74ls00/ComponentTester/FW_Git/ReadMe.md

[WinAVR 20100110](https://sourceforge.net/projects/winavr/files/WinAVR/20100110/)
