74ls00/ComponentTester/HW_EAGLE/ReadMe.txt

Дроссель стабитронов.
Гантелька обмотана 1-2 слоями скотча.
Намотано 49 витков проводом 0.32мм до 100мкгн.
Покрыто густым цапонлаком, насквозь. Не сушил, не было времени.
Обмотано 1-2 слоями скотча.
От конца первичной намотано 400 витков проводом 0.15мм секциями по 100, полученная индуктивность 6.8мгн.
Покрыто цапонлаком в несколько слоёв.
Конец в термоусадке 1мм, связан нитками чтоб не разматывалось.
После сушки. Изолировано 1 слоем скотча.
1 перекрывающий незамкнутый виток медной фольги.
Провод припян с краю и уложен в канавку пайкой внутрь. Край фольги с пайкой оклеен скотчем, фольга намотана на клей "Момент классик".
Обтянуто термоучадкой размер 8 (10мм) растянутой узкогубцами до 12мм, чтоб тоньше было.
