74ls00/ComponentTester/Links/ReadMe.txt

forum.html - список ссылок форума проекта. 

Список содержит ссылки и некоторую группировку, но посколько в теме уже были сотни ст раниц и писался он с большими перерывами в течении нескольких лет, указатели могут быть не полными или изменёнными.

Файл  должен быть открыт в браузере.
Файл не содержит скриптов, но из за большого количества ссылок, хостинги его определяют как мошеннический.
