74ls00/ComponentTester/HW_EAGLE/TODO.txt

2018

резистор 10к со входа транзистора кнопки

***************************************

включение измерителя стабилитронов
pc3 pin26 zener v meter 10:1
config_328.h line:439
config.h line:115

делитель
tools.c line:1670
Value /= 10;                 /* scale to 0.1V */ 
для деления на 20 (вх5в=инд100в) установить 5

конденсатор включения кнопки при проверке стабилитронов чтоб не держать
http://vrtp.ru/index.php?showtopic=16451&view=findpost&p=744082

***************************************

pc4 pin27 relay (line 102) and 2v5 (line 82)

изменить панель гнёзд для всех комбинаций.
gm328
1232123
надо
1232132

old
328p pd4 pin2 измерение частоты.
хейцметр. в хейцгаях

высота платы с чипами 10,5мм
высота реле 9,5мм
	от экрана до платы 20мм
