74ls00/ComponentTester/HW_EAGLE/b333.brd

## EAGLE design HW_EAGLE/b333.brd (2021-04-29)

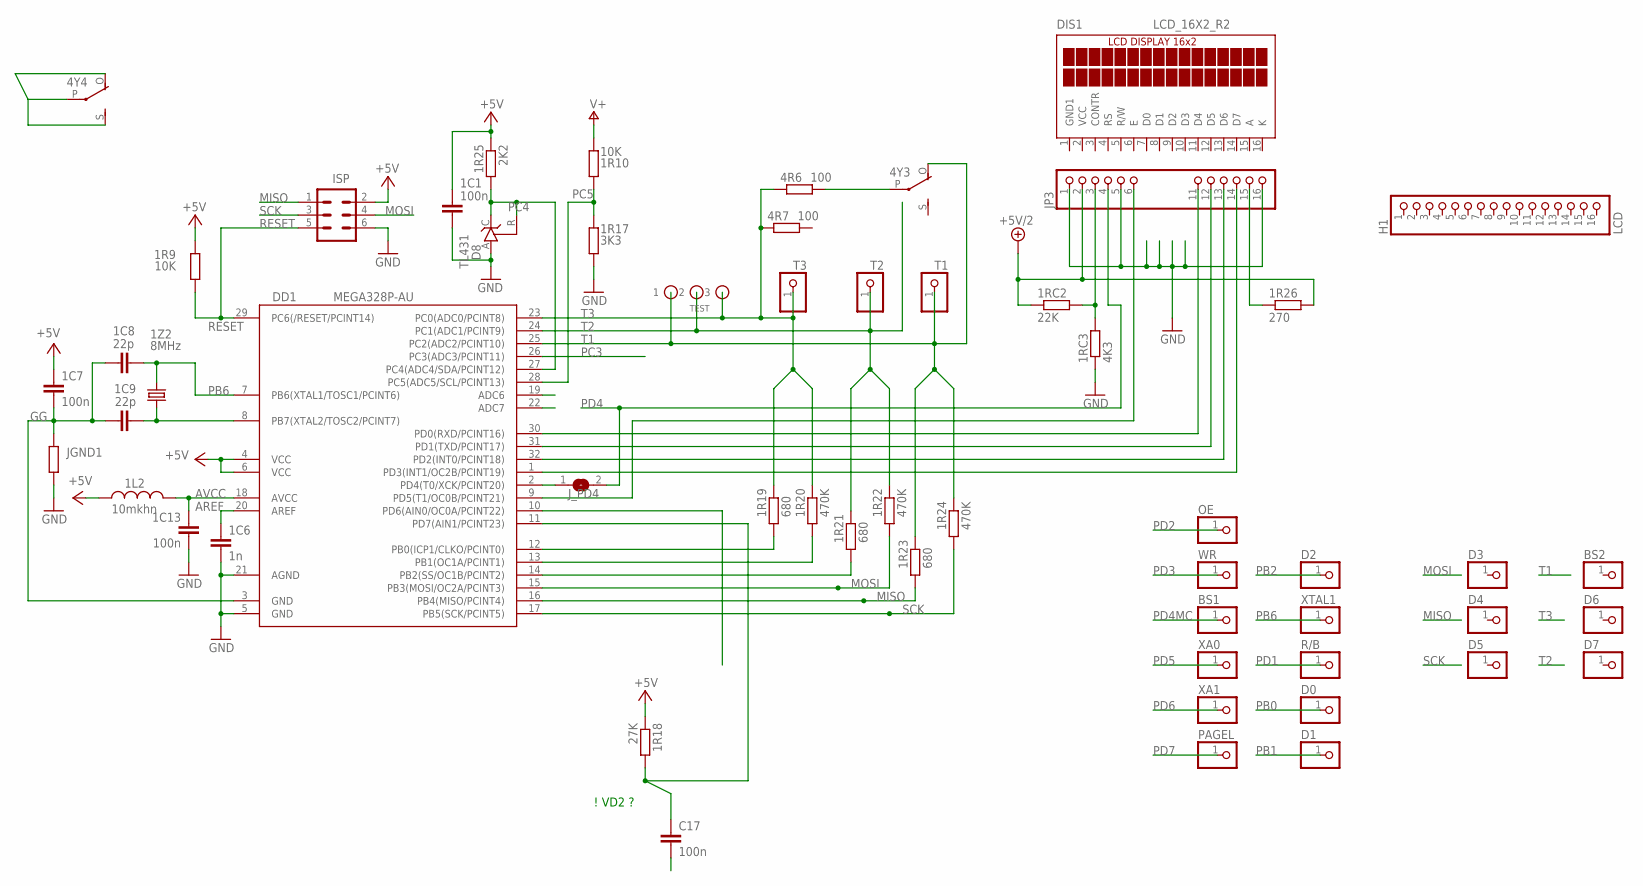
[picture p128: schematic b333.sch, sheet 1]

Parts:
1C1, 1C7, 1C13: 100n; C0805K
1C6: 1n; C0805K
1C8, 1C9: 22p; C0805K
1L2: 10mkhn; IRF36
1R9, 1R10: 10K; R0805
1R17: 3K3; R1206W
1R18: 27K; R0805
1R19, 1R21, 1R23: 680; M0805
1R20, 1R22, 1R24: 470K; M0805
1R25: 2K2; R0805
1R26: 270; R0805
1RC2: 22K; R0805
1RC3: 4K3; R1206W
1Z2: 8MHz; HC49U70
4R6, 4R7: 100; R0805
4Y3, 4Y4: РЭС55А
BS1, BS2: PINHD-1X1; 1X01
C17: 100n; C0805K
D0, D1, D2, D3, D4, D5, D6, D7: PINHD-1X1; 1X01
D8: TL431; TO92-CLP
DD1: MEGA328P-AU; TQFP32-08
DIS1: LCD_16X2_R2
H1: LCD; 1X16
ISP: MA03-2
JGND1: R-EU_R1206W; R1206W
JP3: PINHD-X16-8; 1X16-8
J_PD4: SJ
OE: PINHD-1X1; 1X01
PAGEL: PINHD-1X1; 1X01
R/B: PINHD-1X1; 1X01
T1, T2, T3: PINHD-1X1; 1X01
TEST: TT-P
WR: PINHD-1X1; 1X01
XA0, XA1: PINHD-1X1; 1X01
XTAL1: PINHD-1X1; 1X01

Connections:
+5V: 1C1.1, 1C7.1, 1L2.2, 1R9.2, 1R18.1, 1R25.1, DD1.4 (VCC), DD1.6 (VCC), ISP.2; also elsewhere on the board
+5V/2: 1R26.2, 1RC2.1, JP3.2; also elsewhere on the board
ADC6: DD1.19 (ADC6)
ADC7: DD1.22 (ADC7)
AREF: 1C6.1, DD1.20 (AREF)
AVCC: 1C13.1, 1L2.1, DD1.18 (AVCC)
GG: 1C7.2, 1C8.1, 1C9.1, DD1.3 (GND), JGND1.2
GND: 1C1.2, 1C6.2, 1C13.2, 1R17.1, 1RC3.1, C17.2, D8.A, DD1.5 (GND), DD1.21 (AGND), ISP.6, JGND1.1, JP3.1, JP3.5, JP3.16; also elsewhere on the board
GND1: DIS1.1 (GND1)
MISO: 1R23.1, DD1.16 (PB4(MISO/PCINT4)), ISP.1
MOSI: 1R22.1, DD1.15 (PB3(MOSI/OC2A/PCINT3)), ISP.4
unnamed: 4Y4.O, 4Y4.P, 4Y4.S
unnamed: 1RC2.2, 1RC3.2, JP3.3
unnamed: 1R26.1, JP3.15
unnamed: 1C9.2, 1Z2.1, DD1.8 (PB7(XTAL2/TOSC2/PCINT7))
unnamed: 4R6.2, 4Y3.P
PB0: 1R19.1, D0.1, DD1.12 (PB0(ICP1/CLKO/PCINT0))
PB1: 1R20.1, D1.1, DD1.13 (PB1(OC1A/PCINT1))
PB2: 1R21.1, D2.1, DD1.14 (PB2(SS/OC1B/PCINT2))
PB6: 1C8.2, 1Z2.2, DD1.7 (PB6(XTAL1/TOSC1/PCINT6)), XTAL1.1
PC3: DD1.26 (PC3(ADC3/PCINT11)); also elsewhere on the board
PC4: 1R25.2, D8.C, D8.R, DD1.27 (PC4(ADC4/SDA/PCINT12))
PC5: 1R10.2, 1R17.2, DD1.28 (PC5(ADC5/SCL/PCINT13))
PD0: DD1.30 (PD0(RXD/PCINT16)), JP3.11
PD1: DD1.31 (PD1(TXD/PCINT17)), JP3.12, R/B.1
PD2: DD1.32 (PD2(INT0/PCINT18)), JP3.13, OE.1
PD3: DD1.1 (PD3(INT1/OC2B/PCINT19)), JP3.14, WR.1; also elsewhere on the board
PD4: JP3.4, J_PD4.2
PD4MC: BS1.1, DD1.2 (PD4(T0/XCK/PCINT20)), J_PD4.1
PD5: DD1.9 (PD5(T1/OC0B/PCINT21)), JP3.6, XA0.1
PD6: DD1.10 (PD6(AIN0/OC0A/PCINT22)), XA1.1
PD7: 1R18.2, C17.1, DD1.11 (PD7(AIN1/PCINT23)), PAGEL.1
RESET: 1R9.1, DD1.29 (PC6(/RESET/PCINT14)), ISP.5
SCK: 1R24.1, DD1.17 (PB5(SCK/PCINT5)), ISP.3
T1: 1R23.2, 1R24.2, 4Y3.O, DD1.25 (PC2(ADC2/PCINT10)), T1.1, TEST.P$1 (1)
T2: 1R21.2, 1R22.2, DD1.24 (PC1(ADC1/PCINT9)), T2.1, TEST.P$2 (2), TEST.P$3 (2), TEST.P$4 (2)
T3: 1R19.2, 1R20.2, 4R6.1, 4R7.1, DD1.23 (PC0(ADC0/PCINT8)), T3.1, TEST.P$5 (3)
V+: 1R10.1; also elsewhere on the board
VCC: DIS1.2 (VCC)

Notes on the sheet:
! VD2 ?

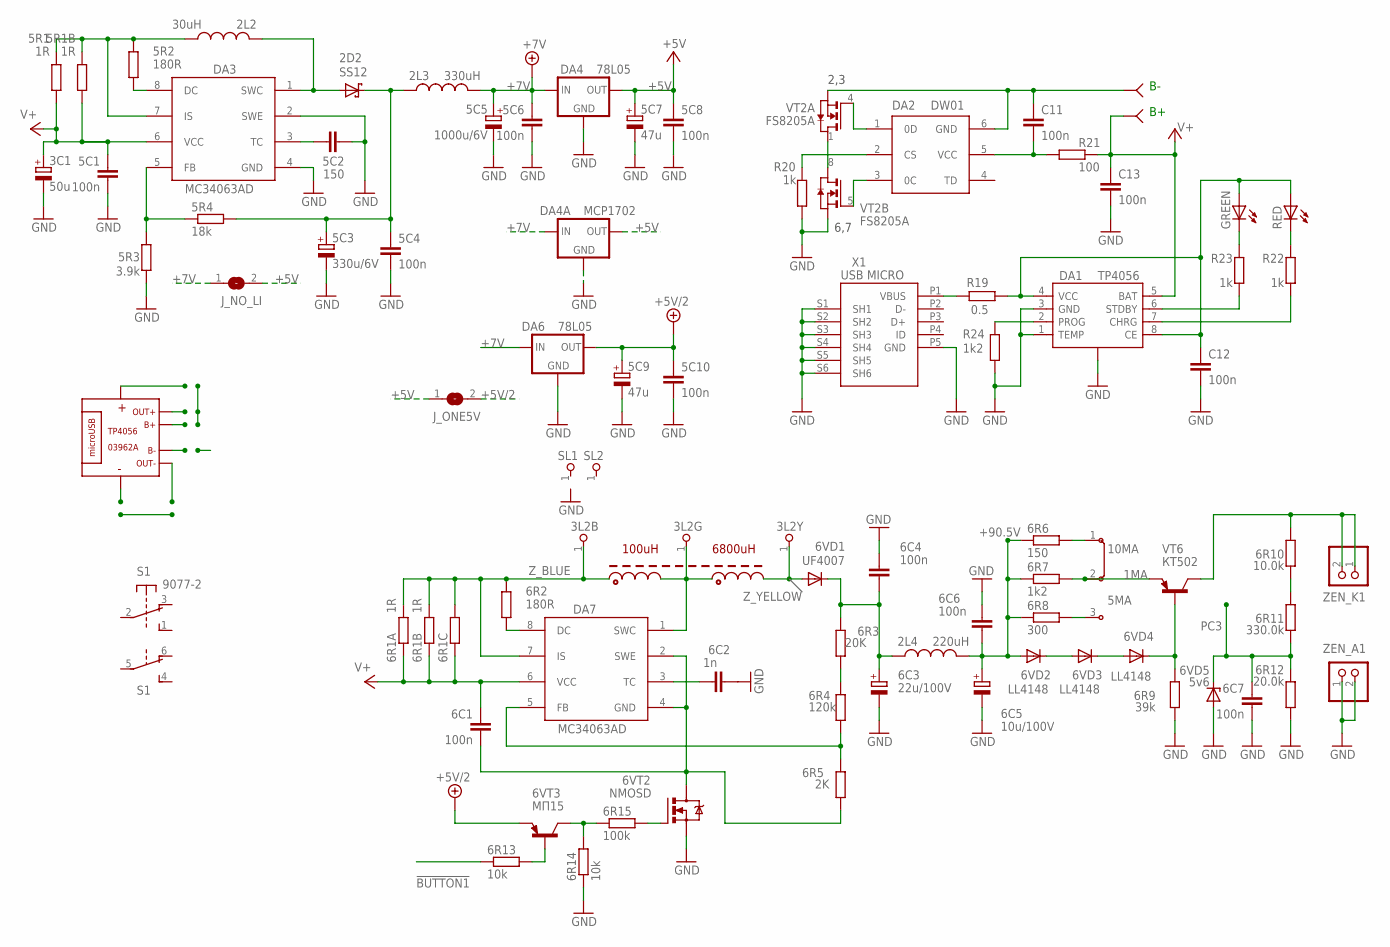
[picture p129: schematic b333.sch, sheet 2]

Parts:
2D2: SS12; SMB
2L2: 30uH; LH7X10MM
2L3: 330uH; LV7X10MM
2L4: 220uH; LV7X10MM
3C1: 50u; E2,5-6
3L2B, 3L2G, 3L2Y: PINHD-1X1; 1X01
5C1, 5C4, 5C6, 5C8, 5C10, 6C1: 100n; C0805K
5C2: 150; C0805K
5C3: 330u/6V; E2,5-7
5C5: 1000u/6V; E2-5
5C7, 5C9: 47u; E2,5-6
5MA: 10MA; JP2
5R1, 5R1B, 6R1A, 6R1B: 1R; R1206
5R2, 6R2: 180R; R0805
5R3: 3.9k; 0204/7
5R4: 18k; R0805
6C2: 1n; C0805K
6C3: 22u/100V; TT5D9L
6C4: 100n; C050-025X075
6C5: 10u/100V; E2,5-6
6C6, 6C7: 100n; C025-025X050
6R1C: R-EU_R1206; R1206
6R3: 20K; R0805
6R4: 120k; R0805
6R5: 2K; R0805
6R6: 150; R0805
6R7: 1k2; R0805
6R8: 300; R0805
6R9: 39k; R0805
6R10: 10.0k; R0805
6R11: 330.0k; R0805
6R12: 20.0k; R0805
6R13: 10k; R1206W
6R14: 10k; R0805
6R15: 100k; R1206W
6VD1: UF4007; DO41-10
6VD2, 6VD3, 6VD4: LL4148; SOD80C
6VD5: 5v6; SOD80C
6VT2: NMOSD; DPACK_1
6VT3: МП15; TO92-BCE
B+: B-; PAD-
B-: B-; PAD-
C11, C12, C13: 100n; C0805
DA1: TP4056; SOP-8
DA2: DW01A; SOT23-6
DA3, DA7: MC34063AD; SOIC8
DA4, DA6: 78L05; SOT89R
DA4A: MCP1702; SOT89R
GREEN: LED5MM
J_NO_LI: SJ
J_ONE5V: SJ
L: L
R19: 0.5; M0805
R20, R22, R23: 1k; R0805
R21: 100; R1206W
R24: 1k2; 0207/10
RED: LED5MM
S1: 9077-2
SL1, SL2: PINHD-1X1; 1X01
U$5: MOD_TP4056; MOD_03962A
VT2: FS8205A; TSSOP-8
VT6: КТ502; TO92-BCE
X1: USB MICRO; CON2_USB_MICRO_B_AT
ZEN_A1: PINHD-1X2; 1X02
ZEN_K1: PINHD-1X2; 1X02

Connections:
1MA: 5MA.2, 6R7.2, VT6.E
5: 6R4.1, 6R5.2, DA7.5 (FB)
!BUTTON1: 6R13.1
+5V: 5C7.+, 5C8.1, DA4.2 (OUT), DA4A.1 (OUT), J_NO_LI.2, J_ONE5V.1; also elsewhere on the board
+5V/2: 5C9.+, 5C10.1, 6VT3.E, DA6.2 (OUT), J_ONE5V.2; also elsewhere on the board
+7V: 2L3.2, 5C5.+, 5C6.1, DA4.1 (IN), DA4A.3 (IN), DA4A.4 (IN), DA6.1 (IN), J_NO_LI.1
+90.5V: 2L4.2, 6C5.+, 6C6.2, 6R6.1, 6R7.1, 6R8.1, 6VD2.A
B-: B-.B-, C11.1, DA2.6 (GND), VT2.2 (S), VT2.3 (S)
GND: 3C1.-, 5C1.2, 5C2.2, 5C3.-, 5C4.2, 5C5.-, 5C6.2, 5C7.-, 5C8.2, 5C9.-, 5C10.2, 5R3.1, 6C2.2, 6C3.-, 6C4.1, 6C5.-, 6C6.1, 6C7.2, 6R9.1, 6R12.1, 6R14.1, 6VD5.A, 6VT2.S, C12.2, C13.2, DA1.1 (TEMP), DA1.3 (GND), DA1.., DA3.2 (SWE), DA3.4 (GND), DA4.3 (GND), DA4.4 (GND), DA4A.2 (GND), DA6.3 (GND), DA6.4 (GND), R20.1, R24.1, VT2.6 (S), VT2.7 (S), X1.P5 (GND), X1.S1 (SH1), X1.S2 (SH2), X1.S3 (SH3), X1.S4 (SH4), X1.S5 (SH5), X1.S6 (SH6), ZEN_A1.1, ZEN_A1.2; also elsewhere on the board
unnamed: R22.2, RED.K (C)
unnamed: GREEN.K (C), R23.2
unnamed: 5C2.1, DA3.3 (TC)
unnamed: 6C1.2, 6R5.1, 6VT2.D, DA7.2 (SWE), DA7.4 (GND)
unnamed: 2D2.A, 2L2.1, DA3.1 (SWC)
unnamed: 2L2.2, 5R1.2, 5R1B.2, 5R2.1, DA3.7 (IS)
unnamed: 5R2.2, DA3.8 (DC)
unnamed: 5R3.2, 5R4.1, DA3.5 (FB)
unnamed: 2D2.C, 2L3.1, 5C3.+, 5C4.1, 5R4.2
unnamed: 2L4.1, 6C3.+, 6C4.2, 6R3.2, 6VD1.C
unnamed: 6R14.2, 6R15.1, 6VT3.C
unnamed: 6C2.1, DA7.3 (TC)
unnamed: 6R3.1, 6R4.2
unnamed: 6R10.1, 6R11.2
unnamed: 6R2.2, DA7.8 (DC)
unnamed: 5MA.3, 6R8.2
unnamed: 5MA.1, 6R6.2
unnamed: 6VD2.C, 6VD3.A
unnamed: 6VD3.C, 6VD4.A
unnamed: 6R9.2, 6VD4.C, VT6.B
unnamed: VT2.1 (D), VT2.8 (D)
unnamed: DA2.3 (0C), VT2.5 (G)
unnamed: DA2.1 (0D), VT2.4 (G)
unnamed: DA2.2 (CS), R20.2
unnamed: C11.2, DA2.5 (VCC), R21.1
unnamed: DA1.7 (CHRG), R22.1
unnamed: DA1.6 (STDBY), R23.1
unnamed: C12.1, DA1.4 (VCC), DA1.8 (CE), GREEN.A, R19.2, RED.A
unnamed: R19.1, X1.P1 (VBUS)
unnamed: DA1.2 (PROG), R24.2
unnamed: 6R13.2, 6VT3.B
unnamed: 6R15.2, 6VT2.G
PC3: 6C7.1, 6R11.1, 6R12.2, 6VD5.C; also elsewhere on the board
V+: 3C1.+, 5C1.1, 5R1.1, 5R1B.1, 6C1.1, 6R1A.1, 6R1B.1, 6R1C.1, B+.B-, C13.1, DA1.5 (BAT), DA3.6 (VCC), DA7.6 (VCC), R21.2; also elsewhere on the board
ZENER: 6R10.2, VT6.C, ZEN_K1.1, ZEN_K1.2
Z_BLUE: 3L2B.1, 6R1A.2, 6R1B.2, 6R1C.2, 6R2.1, DA7.7 (IS)
Z_GREEN: 3L2G.1, DA7.1 (SWC)
Z_YELLOW: 3L2Y.1, 6VD1.A

Notes on the sheet:
6800uH
100uH
2,3
6,7

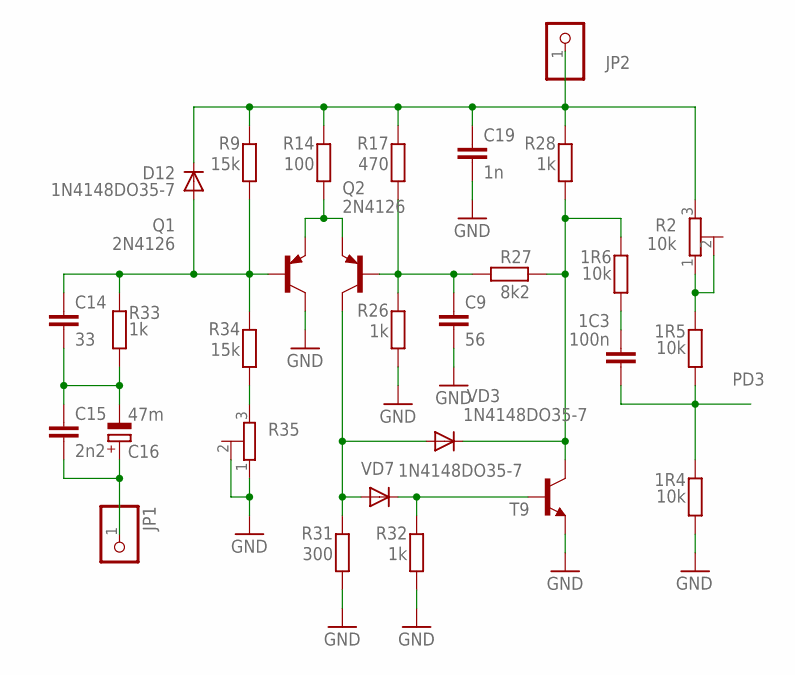
[picture p130: schematic b333.sch, sheet 3]

Parts:
1C3: 100n; C0805K
1R4, 1R5, 1R6: 10k; R0805
C9: 56; C0805K
C14: 33; C0805K
C15: 2n2; C0805K
C16: 47m; E2-4
C19: 1n; C0805K
D12: 1N4148DO35-7; DO35-7
JP1, JP2: PINHD-1X1; 1X01
Q1, Q2: 2N4126; TO92-CBE
R2: 10k; RTRIM3296W
R9, R34: 15k; M0805
R14: 100; M0805
R17: 470; M0805
R26, R28, R32, R33: 1k; M0805
R27: 8k2; M0805
R31: 300; M0805
R35: R-TRIMM3296W; RTRIM3296W
T9: -NPN-TO92-EBC; TO92-EBC
VD3, VD7: 1N4148DO35-7; DO35-7

Connections:
FO: 1R6.2, R27.2, R28.1, T9.C, VD3.C
GND: 1R4.1, C9.2, C19.2, Q1.C, R26.1, R31.1, R32.1, R35.1 (A), R35.2 (S), T9.E; also elsewhere on the board
unnamed: C19.1, D12.C, JP2.1, R2.3 (E), R9.2, R14.2, R17.2, R28.2
unnamed: R34.1, R35.3 (E)
unnamed: 1R5.2, R2.1 (A), R2.2 (S)
unnamed: 1C3.1, 1R6.1
unnamed: Q1.E, Q2.E, R14.1
unnamed: C14.1, D12.A, Q1.B, R9.1, R33.2, R34.2
unnamed: C9.1, Q2.B, R17.1, R26.2, R27.1
unnamed: Q2.C, R31.2, VD3.A, VD7.A
unnamed: C14.2, C15.1, C16.-, R33.1
unnamed: R32.2, T9.B, VD7.C
unnamed: C15.2, C16.+, JP1.1
PD3: 1C3.2, 1R4.2, 1R5.1; also elsewhere on the board

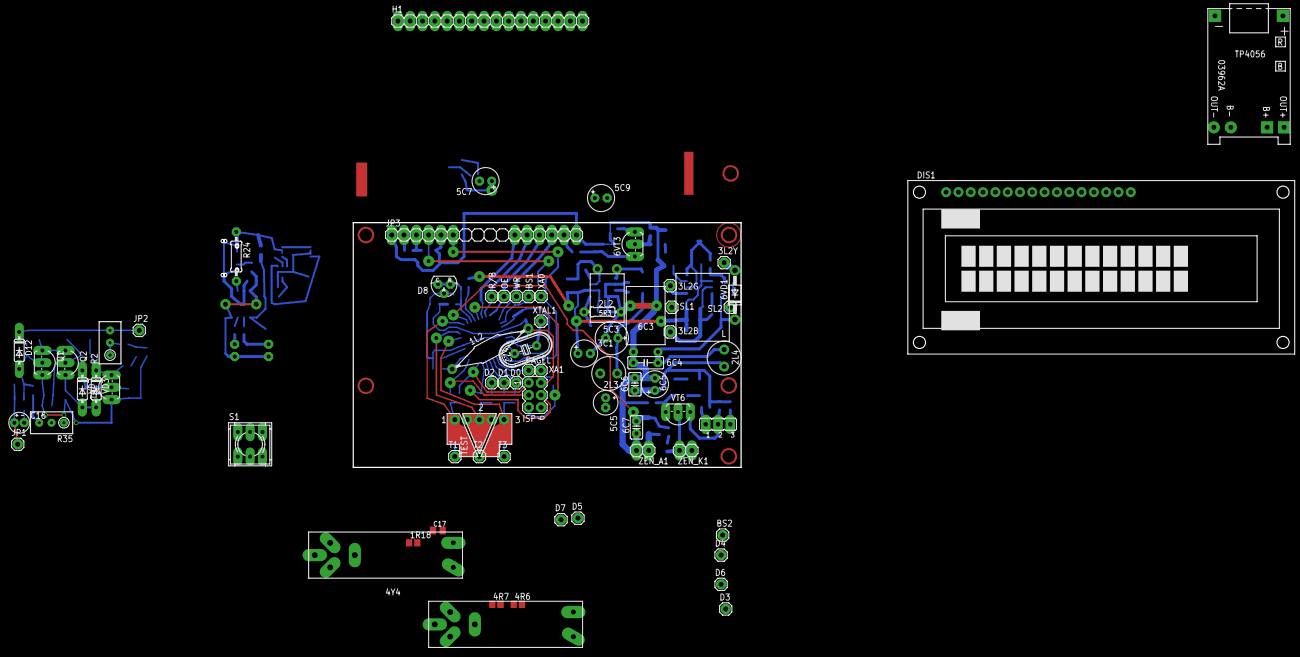
[picture p131: board b333.brd from above]

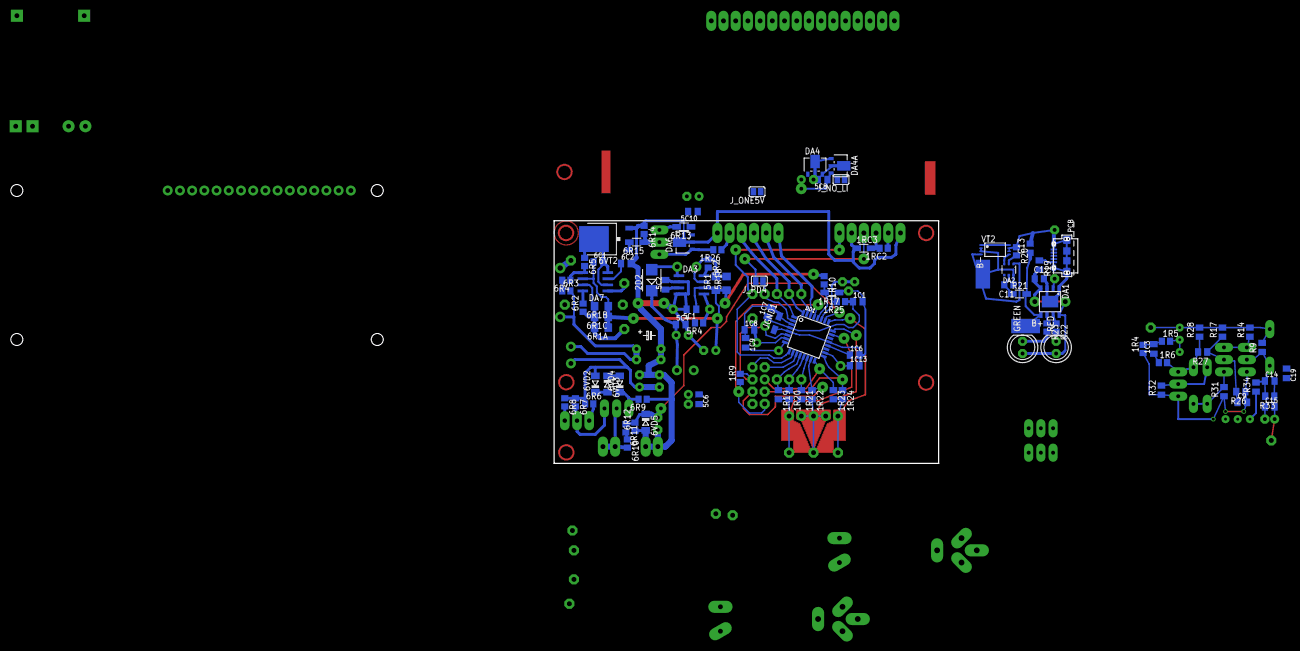
[picture p132: board b333.brd from below]

Board: 2 copper layers, 80.0 x 50.5 mm, 174 parts (98 on the bottom side), 88 nets.

Other parts of the board:
U$8, U$11: F18650
