74ls00/ComponentTester/(commit log)

2018-10-21 34063 links
    [b333.brd, b333.sch]
2018-10-21 add lnk
    [b333.brd, b333.sch]
2018-11-14 pp pin
    [b333.brd, b333.sch]
